purduerov/X19-USB-Hub-Board/X19-USB-Hub-Board.kicad_pcb

## KiCad design X19-USB-Hub-Board.kicad_pcb (2026-10-24)

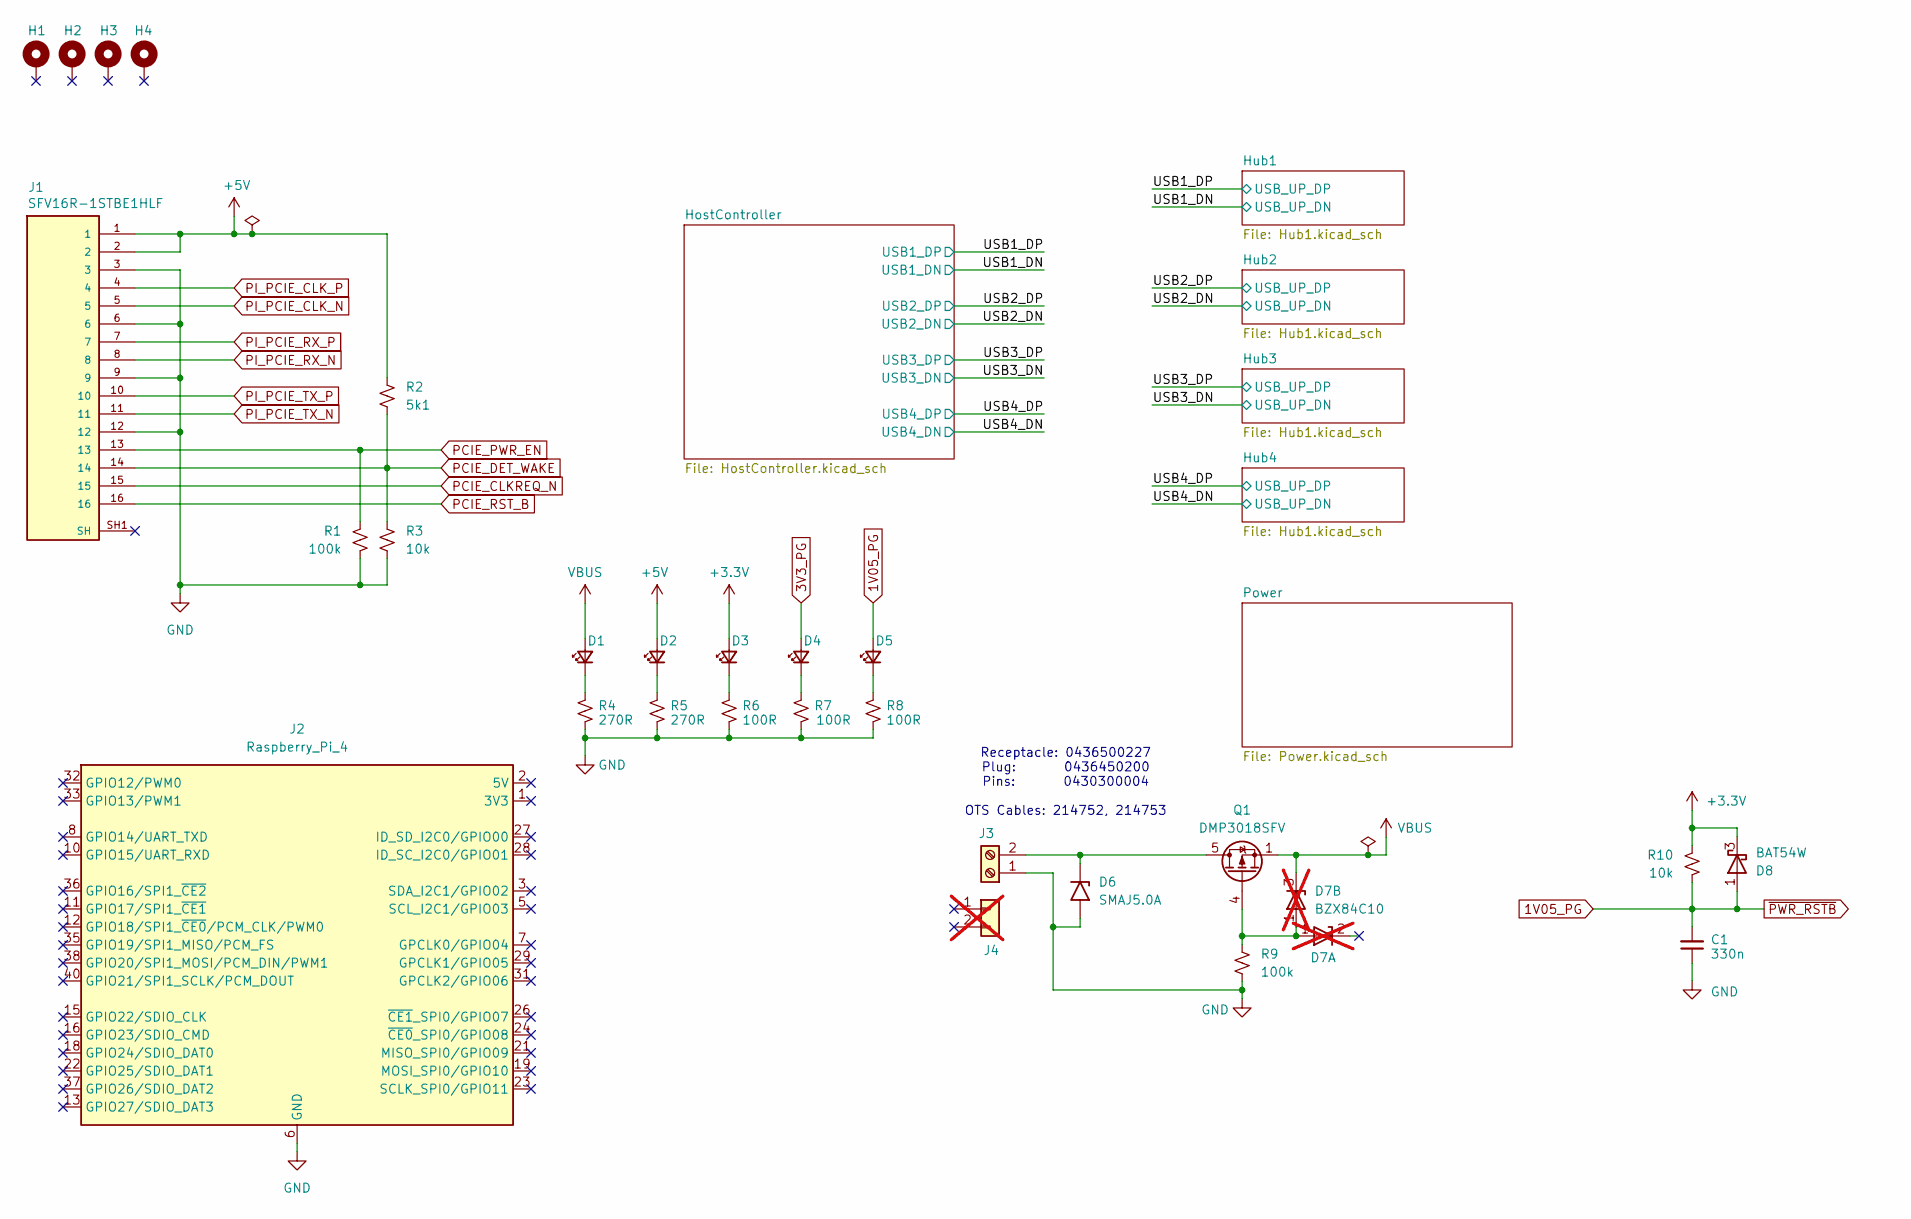
[picture p1: schematic X19-USB-Hub-Board.kicad_sch]

Parts:
C1: 330n; C_0402_1005Metric; Part Number CC0402KPX5R6BB334
D1, D2, D3, D4, D5: LED_Small; LED_0603_1608Metric; Part Number LTST-C190GKT
D6: SMAJ5.0A; D_SMA; Part Number SMAJ5.0A
D7: BZX84C10; SOT-23; Part Number BZX84C10; not fitted
D8: BAT54W; SOT-323_SC-70; Part Number BAT54W
H1, H2, H3, H4: MountingHole_Pad; MountingHole_2.7mm_M2.5_Pad
J1: SFV16R-1STBE1HLF; AMPHENOL_SFV16R-1STBE1HLF; PARTREV B; DigiKey 609-1786-1-ND
J2: Raspberry_Pi_4; PinSocket_2x20_P2.54mm_Vertical
J3: 0436500227; Part Number 1053131102
J4: 0436450200; Part Number 0436450200; not fitted
Q1: DMP3018SFV; Diodes_PowerDI3333-8; Part Number DMP3018SFV
R1, R9: 100k; R_0603_1608Metric; Part Number RC0603FR-07100KL
R2: 5k1; R_0603_1608Metric; Part Number RC0603FR-075K1L
R3, R10: 10k; R_0402_1005Metric; Part Number RC0402FR-0710KL
R4, R5: 270R; R_0603_1608Metric; Part Number RC0603FR-07270RL
R6, R7, R8: 100R; R_0603_1608Metric; Part Number RC0603FR-07100RL

Connections:
1V05_PG: C1.2, D5.2 (A), D8.1 (A), R10.2; also elsewhere on the board
3V3_PG: D4.2 (A); also elsewhere on the board
+3.3V: D3.2 (A), D8.3 (K), R10.1; also elsewhere on the board
+5V: D2.2 (A), J1.1, J1.2, R2.1; also elsewhere on the board
GND: C1.1, D6.2 (A2), J1.3, J1.6, J1.9, J1.12, J2.6 (GND), J2.9 (GND), J2.14 (GND), J2.20 (GND), J2.25 (GND), J2.30 (GND), J2.34 (GND), J2.39 (GND), J3.1, R1.2, R3.2, R4.1, R5.1, R6.1, R7.1, R8.1, R9.2; also elsewhere on the board
unnamed: D1.1 (K), R4.2
unnamed: D2.1 (K), R5.2
unnamed: D3.1 (K), R6.2
unnamed: D4.1 (K), R7.2
unnamed: D5.1 (K), R8.2
unnamed: D6.1 (A1), J3.2, Q1.5 (D)
unnamed: D7.1 (A), Q1.4 (G), R9.1
PCIE_CLKREQ_N: J1.15; also elsewhere on the board
PCIE_DET_WAKE: J1.14, R2.2, R3.1; also elsewhere on the board
PCIE_PWR_EN: J1.13, R1.1; also elsewhere on the board
PCIE_RST_B: J1.16; also elsewhere on the board
PI_PCIE_CLK_N: J1.5; also elsewhere on the board
PI_PCIE_CLK_P: J1.4; also elsewhere on the board
PI_PCIE_RX_N: J1.8; also elsewhere on the board
PI_PCIE_RX_P: J1.7; also elsewhere on the board
PI_PCIE_TX_N: J1.11; also elsewhere on the board
PI_PCIE_TX_P: J1.10; also elsewhere on the board
VBUS: D1.2 (A), D7.3 (K), Q1.1 (S), Q1.2 (S), Q1.3 (S); also elsewhere on the board

Notes on the sheet:
Receptacle: 0436500227 Plug: 0436450200 Pins: 0430300004 OTS Cables: 214752, 214753

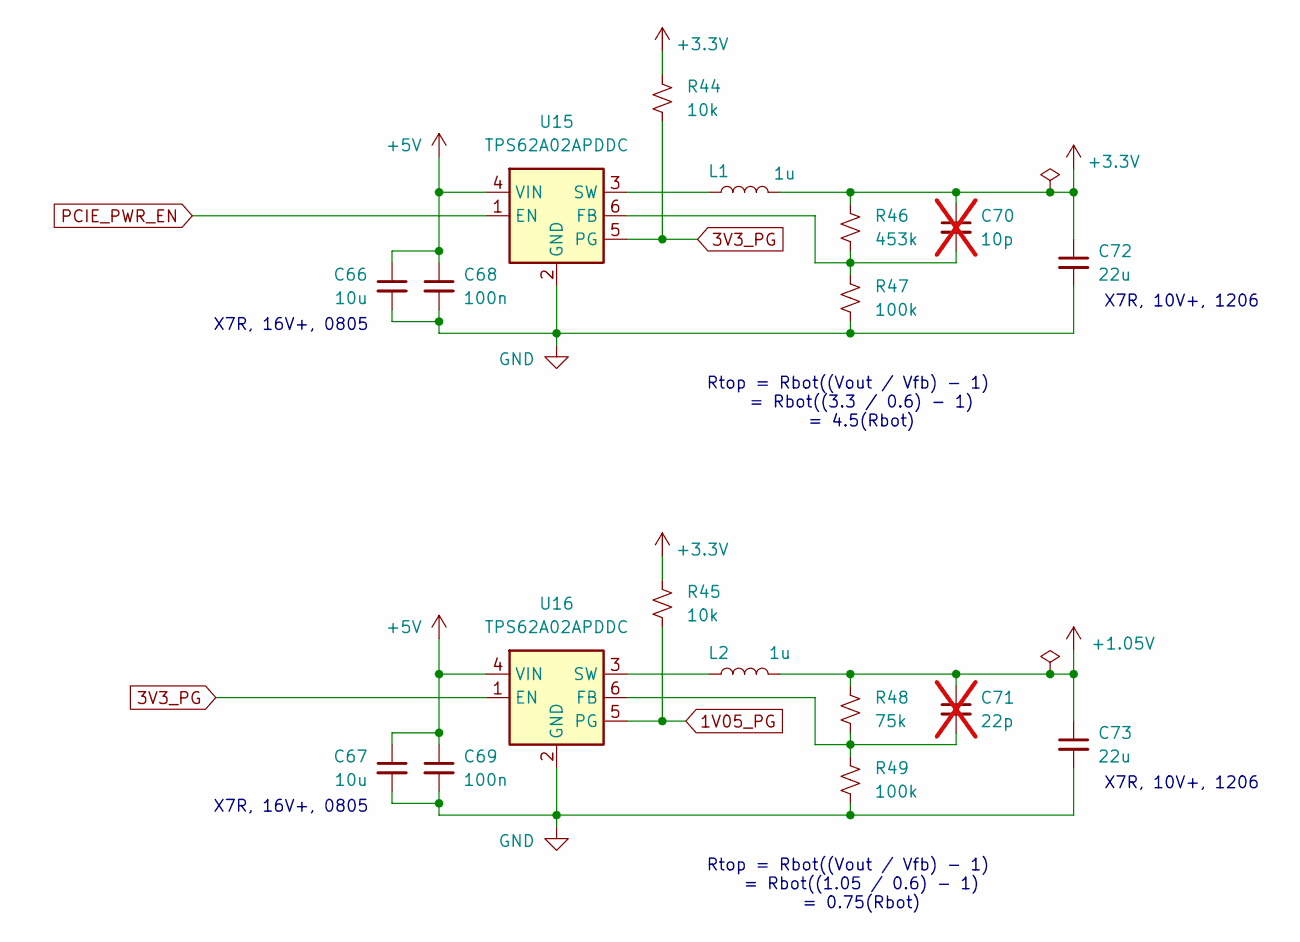
[picture p2: schematic Power.kicad_sch]

Parts:
C66, C67: 10u; C_0805_2012Metric; Part Number CC0805KRX5R8BB106
C68, C69: 100n; C_0402_1005Metric; Part Number CC0402KRX7R8BB104
C70: 10p; C_0402_1005Metric; Part Number CC0402JRNPO9BN100; not fitted
C71: 22p; C_0402_1005Metric; Part Number CC0402JRNPO9BN220; not fitted
C72, C73: 22u; C_1206_3216Metric; Part Number CC1206KKX5R8BB226
L1, L2: 1u; L_1008_2520Metric; Part Number DFE252012F-1R0M
R44, R45: 10k; R_0402_1005Metric; Part Number RC0402FR-0710KL
R46: 453k; R_0603_1608Metric; Part Number RC0603FR-07453KL
R47, R49: 100k; R_0603_1608Metric; Part Number RC0603FR-07100KL
R48: 75k; R_0603_1608Metric; Part Number RC0603FR-0775KL
U15, U16: TPS62A02APDDC; SOT-23-6; Part Number TPS62A02APDDC

Connections:
1V05_PG: R45.2, U16.5 (PG); also elsewhere on the board
3V3_PG: R44.2, U15.5 (PG), U16.1 (EN); also elsewhere on the board
+1.05V: C71.1, C73.1, L2.2, R48.1; also elsewhere on the board
+3.3V: C70.1, C72.1, L1.2, R44.1, R45.1, R46.1; also elsewhere on the board
+5V: C66.1, C67.1, C68.1, C69.1, U15.4 (VIN), U16.4 (VIN); also elsewhere on the board
GND: C66.2, C67.2, C68.2, C69.2, C72.2, C73.2, R47.2, R49.2, U15.2 (GND), U16.2 (GND); also elsewhere on the board
unnamed: C70.2, R46.2, R47.1, U15.6 (FB)
unnamed: L1.1, U15.3 (SW)
unnamed: C71.2, R48.2, R49.1, U16.6 (FB)
unnamed: L2.1, U16.3 (SW)
PCIE_PWR_EN: U15.1 (EN); also elsewhere on the board

Notes on the sheet:
X7R, 10V+, 1206
Rtop = Rbot((Vout / Vfb) - 1) = Rbot((1.05 / 0.6) - 1) = 0.75(Rbot)
Rtop = Rbot((Vout / Vfb) - 1) = Rbot((3.3 / 0.6) - 1) = 4.5(Rbot)
X7R, 16V+, 0805

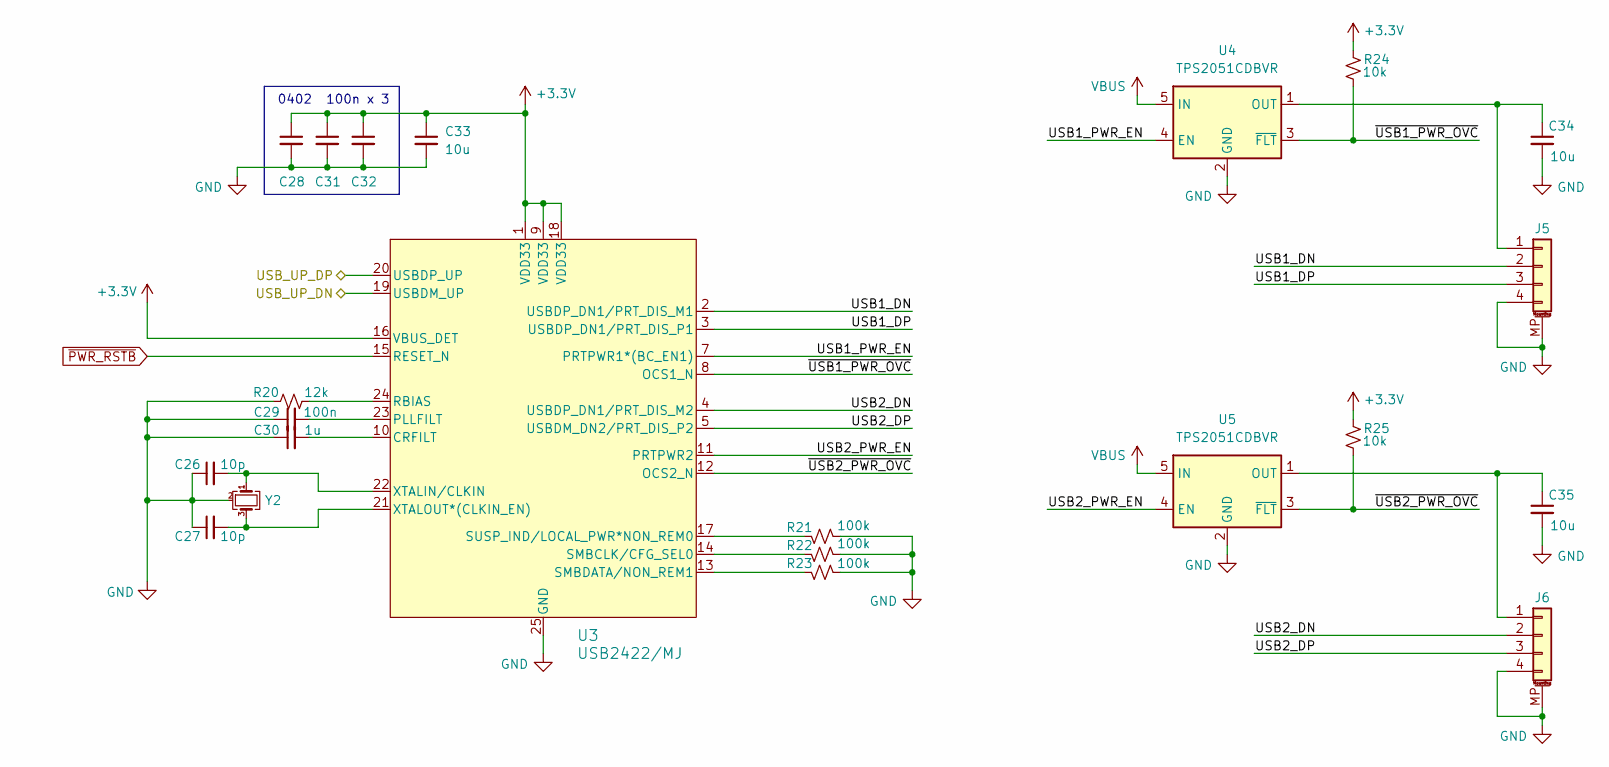
[picture p3: schematic Hub1.kicad_sch]

Parts:
C26, C27: 10p; C_0402_1005Metric; Part Number CC0402JRNPO9BN100
C28, C29, C31, C32: 100n; C_0402_1005Metric; Part Number CC0402KRX7R8BB104
C30: 1u; C_0603_1608Metric; Part Number CC0603KRX5R6BB105
C33, C34, C35: 10u; C_0805_2012Metric; Part Number CC0805KRX5R8BB106
J5, J6: BM04B-SRSS-TB; JST_SH_BM04B-SRSS-TB_1x04-1MP_P1.00mm_Vertical; Part Number BM04B-SRSS-TB
R20: 12k; R_0603_1608Metric; Part Number RC0603FR-0712KL
R21, R22, R23: 100k; R_0603_1608Metric; Part Number RC0603FR-07100KL
R24, R25: 10k; R_0402_1005Metric; Part Number RC0402FR-0710KL
U3: USB2422/MJ; QFN-24-1EP_4x4mm_P0.5mm_EP2.5x2.5mm_ThermalVias; Part Number USB2422/MJ; DigiKey USB2422/MJ-ND
U4, U5: TPS2051CDBVR; SOT-23-5; Part Number TPS2051CDBVR
Y2: ECS-240-8-37B-CKY-TR; Crystal_SMD_2016-4Pin_2.0x1.6mm; Part Number ECS-240-8-37B-CKY-TR

Connections:
1V05_PG: U3.15 (RESET_N); also elsewhere on the board
+3.3V: C28.1, C31.1, C32.1, C33.1, R24.1, R25.1, U3.1 (VDD33), U3.9 (VDD33), U3.16 (VBUS_DET), U3.18 (VDD33); also elsewhere on the board
/Hub1/USB1_DN: J5.2, U3.2 (USBDP_DN1/PRT_DIS_M1)
/Hub1/USB1_DP: J5.3, U3.3 (USBDP_DN1/PRT_DIS_P1)
/Hub1/USB1_PWR_EN: U3.7 (PRTPWR1*(BC_EN1)), U4.4 (EN)
/Hub1/USB2_DN: J6.2, U3.4 (USBDP_DN1/PRT_DIS_M2)
/Hub1/USB2_DP: J6.3, U3.5 (USBDM_DN2/PRT_DIS_P2)
/Hub1/USB2_PWR_EN: U3.11 (PRTPWR2), U5.4 (EN)
/Hub1/~USB1_PWR_OVC: R24.2, U3.8 (OCS1_N), U4.3 (~FLT)
/Hub1/~USB2_PWR_OVC: R25.2, U3.12 (OCS2_N), U5.3 (~FLT)
/USB1_DN: U3.19 (USBDM_UP); also elsewhere on the board
/USB1_DP: U3.20 (USBDP_UP); also elsewhere on the board
GND: C26.1, C27.1, C28.2, C29.1, C30.1, C31.2, C32.2, C33.2, C34.2, C35.2, J5.4, J5.MP (MountPin), J6.4, J6.MP (MountPin), R20.1, R21.2, R22.2, R23.2, U3.25 (GND), U4.2 (GND), U5.2 (GND), Y2.2 (G), Y2.4 (G); also elsewhere on the board
unnamed: C34.1, J5.1, U4.1 (OUT)
unnamed: C35.1, J6.1, U5.1 (OUT)
unnamed: C30.2, U3.10 (CRFILT)
unnamed: C29.2, U3.23 (PLLFILT)
unnamed: R20.2, U3.24 (RBIAS)
unnamed: R22.1, U3.14 (SMBCLK/CFG_SEL0)
unnamed: R23.1, U3.13 (SMBDATA/NON_REM1)
unnamed: R21.1, U3.17 (SUSP_IND/LOCAL_PWR*NON_REM0)
unnamed: C26.2, U3.22 (XTALIN/CLKIN), Y2.1
unnamed: C27.2, U3.21 (XTALOUT*(CLKIN_EN)), Y2.3
VBUS: U4.5 (IN), U5.5 (IN); also elsewhere on the board

Parts of its further copies:
C36, C37, C46, C47, C56, C57: 10p; C_0402_1005Metric; Part Number CC0402JRNPO9BN100
C38, C39, C41, C42, C48, C49, C51, C52, C58, C59, C61, C62: 100n; C_0402_1005Metric; Part Number CC0402KRX7R8BB104
C40, C50, C60: 1u; C_0603_1608Metric; Part Number CC0603KRX5R6BB105
C43, C44, C45, C53, C54, C55, C63, C64, C65: 10u; C_0805_2012Metric; Part Number CC0805KRX5R8BB106
J7, J8, J9, J10, J11, J12: BM04B-SRSS-TB; JST_SH_BM04B-SRSS-TB_1x04-1MP_P1.00mm_Vertical; Part Number BM04B-SRSS-TB
R26, R32, R38: 12k; R_0603_1608Metric; Part Number RC0603FR-0712KL
R27, R28, R29, R33, R34, R35, R39, R40, R41: 100k; R_0603_1608Metric; Part Number RC0603FR-07100KL
R30, R31, R36, R37, R42, R43: 10k; R_0402_1005Metric; Part Number RC0402FR-0710KL
U6, U9, U12: USB2422/MJ; QFN-24-1EP_4x4mm_P0.5mm_EP2.5x2.5mm_ThermalVias; Part Number USB2422/MJ; DigiKey USB2422/MJ-ND
U7, U8, U10, U11, U13, U14: TPS2051CDBVR; SOT-23-5; Part Number TPS2051CDBVR
Y3, Y4, Y5: ECS-240-8-37B-CKY-TR; Crystal_SMD_2016-4Pin_2.0x1.6mm; Part Number ECS-240-8-37B-CKY-TR

Connections of its further copies:
1V05_PG: U6.15 (RESET_N), U9.15 (RESET_N), U12.15 (RESET_N); also elsewhere on the board
+3.3V: C38.1, C41.1, C42.1, C43.1, C48.1, C51.1, C52.1, C53.1, C58.1, C61.1, C62.1, C63.1, R30.1, R31.1, R36.1, R37.1, R42.1, R43.1, U6.1 (VDD33), U6.9 (VDD33), U6.16 (VBUS_DET), U6.18 (VDD33), U9.1 (VDD33), U9.9 (VDD33), U9.16 (VBUS_DET), U9.18 (VDD33), U12.1 (VDD33), U12.9 (VDD33), U12.16 (VBUS_DET), U12.18 (VDD33); also elsewhere on the board
/Hub2/USB1_DN: J7.2, U6.2 (USBDP_DN1/PRT_DIS_M1)
/Hub2/USB1_DP: J7.3, U6.3 (USBDP_DN1/PRT_DIS_P1)
/Hub2/USB1_PWR_EN: U6.7 (PRTPWR1*(BC_EN1)), U7.4 (EN)
/Hub2/USB2_DN: J8.2, U6.4 (USBDP_DN1/PRT_DIS_M2)
/Hub2/USB2_DP: J8.3, U6.5 (USBDM_DN2/PRT_DIS_P2)
/Hub2/USB2_PWR_EN: U6.11 (PRTPWR2), U8.4 (EN)
/Hub2/~USB1_PWR_OVC: R30.2, U6.8 (OCS1_N), U7.3 (~FLT)
/Hub2/~USB2_PWR_OVC: R31.2, U6.12 (OCS2_N), U8.3 (~FLT)
/Hub3/USB1_DN: J9.2, U9.2 (USBDP_DN1/PRT_DIS_M1)
/Hub3/USB1_DP: J9.3, U9.3 (USBDP_DN1/PRT_DIS_P1)
/Hub3/USB1_PWR_EN: U9.7 (PRTPWR1*(BC_EN1)), U10.4 (EN)
/Hub3/USB2_DN: J10.2, U9.4 (USBDP_DN1/PRT_DIS_M2)
/Hub3/USB2_DP: J10.3, U9.5 (USBDM_DN2/PRT_DIS_P2)
/Hub3/USB2_PWR_EN: U9.11 (PRTPWR2), U11.4 (EN)
/Hub3/~USB1_PWR_OVC: R36.2, U9.8 (OCS1_N), U10.3 (~FLT)
/Hub3/~USB2_PWR_OVC: R37.2, U9.12 (OCS2_N), U11.3 (~FLT)
/Hub4/USB1_DN: J11.2, U12.2 (USBDP_DN1/PRT_DIS_M1)
/Hub4/USB1_DP: J11.3, U12.3 (USBDP_DN1/PRT_DIS_P1)
/Hub4/USB1_PWR_EN: U12.7 (PRTPWR1*(BC_EN1)), U13.4 (EN)
/Hub4/USB2_DN: J12.2, U12.4 (USBDP_DN1/PRT_DIS_M2)
/Hub4/USB2_DP: J12.3, U12.5 (USBDM_DN2/PRT_DIS_P2)
/Hub4/USB2_PWR_EN: U12.11 (PRTPWR2), U14.4 (EN)
/Hub4/~USB1_PWR_OVC: R42.2, U12.8 (OCS1_N), U13.3 (~FLT)
/Hub4/~USB2_PWR_OVC: R43.2, U12.12 (OCS2_N), U14.3 (~FLT)
/USB2_DN: U6.19 (USBDM_UP); also elsewhere on the board
/USB2_DP: U6.20 (USBDP_UP); also elsewhere on the board
/USB3_DN: U9.19 (USBDM_UP); also elsewhere on the board
/USB3_DP: U9.20 (USBDP_UP); also elsewhere on the board
/USB4_DN: U12.19 (USBDM_UP); also elsewhere on the board
/USB4_DP: U12.20 (USBDP_UP); also elsewhere on the board
GND: C36.1, C37.1, C38.2, C39.1, C40.1, C41.2, C42.2, C43.2, C44.2, C45.2, C46.1, C47.1, C48.2, C49.1, C50.1, C51.2, C52.2, C53.2, C54.2, C55.2, C56.1, C57.1, C58.2, C59.1, C60.1, C61.2, C62.2, C63.2, C64.2, C65.2, J7.4, J7.MP (MountPin), J8.4, J8.MP (MountPin), J9.4, J9.MP (MountPin), J10.4, J10.MP (MountPin), J11.4, J11.MP (MountPin), J12.4, J12.MP (MountPin), R26.1, R27.2, R28.2, R29.2, R32.1, R33.2, R34.2, R35.2, R38.1, R39.2, R40.2, R41.2, U6.25 (GND), U7.2 (GND), U8.2 (GND), U9.25 (GND), U10.2 (GND), U11.2 (GND), U12.25 (GND), U13.2 (GND), U14.2 (GND), Y3.2 (G), Y3.4 (G), Y4.2 (G), Y4.4 (G), Y5.2 (G), Y5.4 (G); also elsewhere on the board
unnamed: C44.1, J7.1, U7.1 (OUT)
unnamed: C45.1, J8.1, U8.1 (OUT)
unnamed: C54.1, J9.1, U10.1 (OUT)
unnamed: C55.1, J10.1, U11.1 (OUT)
unnamed: C64.1, J11.1, U13.1 (OUT)
unnamed: C65.1, J12.1, U14.1 (OUT)
unnamed: C40.2, U6.10 (CRFILT)
unnamed: C39.2, U6.23 (PLLFILT)
unnamed: R26.2, U6.24 (RBIAS)
unnamed: R28.1, U6.14 (SMBCLK/CFG_SEL0)
unnamed: R29.1, U6.13 (SMBDATA/NON_REM1)
unnamed: R27.1, U6.17 (SUSP_IND/LOCAL_PWR*NON_REM0)
unnamed: C36.2, U6.22 (XTALIN/CLKIN), Y3.1
unnamed: C37.2, U6.21 (XTALOUT*(CLKIN_EN)), Y3.3
unnamed: C50.2, U9.10 (CRFILT)
unnamed: C49.2, U9.23 (PLLFILT)
unnamed: R32.2, U9.24 (RBIAS)
unnamed: R34.1, U9.14 (SMBCLK/CFG_SEL0)
unnamed: R35.1, U9.13 (SMBDATA/NON_REM1)
unnamed: R33.1, U9.17 (SUSP_IND/LOCAL_PWR*NON_REM0)
unnamed: C46.2, U9.22 (XTALIN/CLKIN), Y4.1
unnamed: C47.2, U9.21 (XTALOUT*(CLKIN_EN)), Y4.3
unnamed: C60.2, U12.10 (CRFILT)
unnamed: C59.2, U12.23 (PLLFILT)
unnamed: R38.2, U12.24 (RBIAS)
unnamed: R40.1, U12.14 (SMBCLK/CFG_SEL0)
unnamed: R41.1, U12.13 (SMBDATA/NON_REM1)
unnamed: R39.1, U12.17 (SUSP_IND/LOCAL_PWR*NON_REM0)
unnamed: C56.2, U12.22 (XTALIN/CLKIN), Y5.1
unnamed: C57.2, U12.21 (XTALOUT*(CLKIN_EN)), Y5.3
VBUS: U7.5 (IN), U8.5 (IN), U10.5 (IN), U11.5 (IN), U13.5 (IN), U14.5 (IN); also elsewhere on the board

Notes on the sheet:
0402
100n x 3

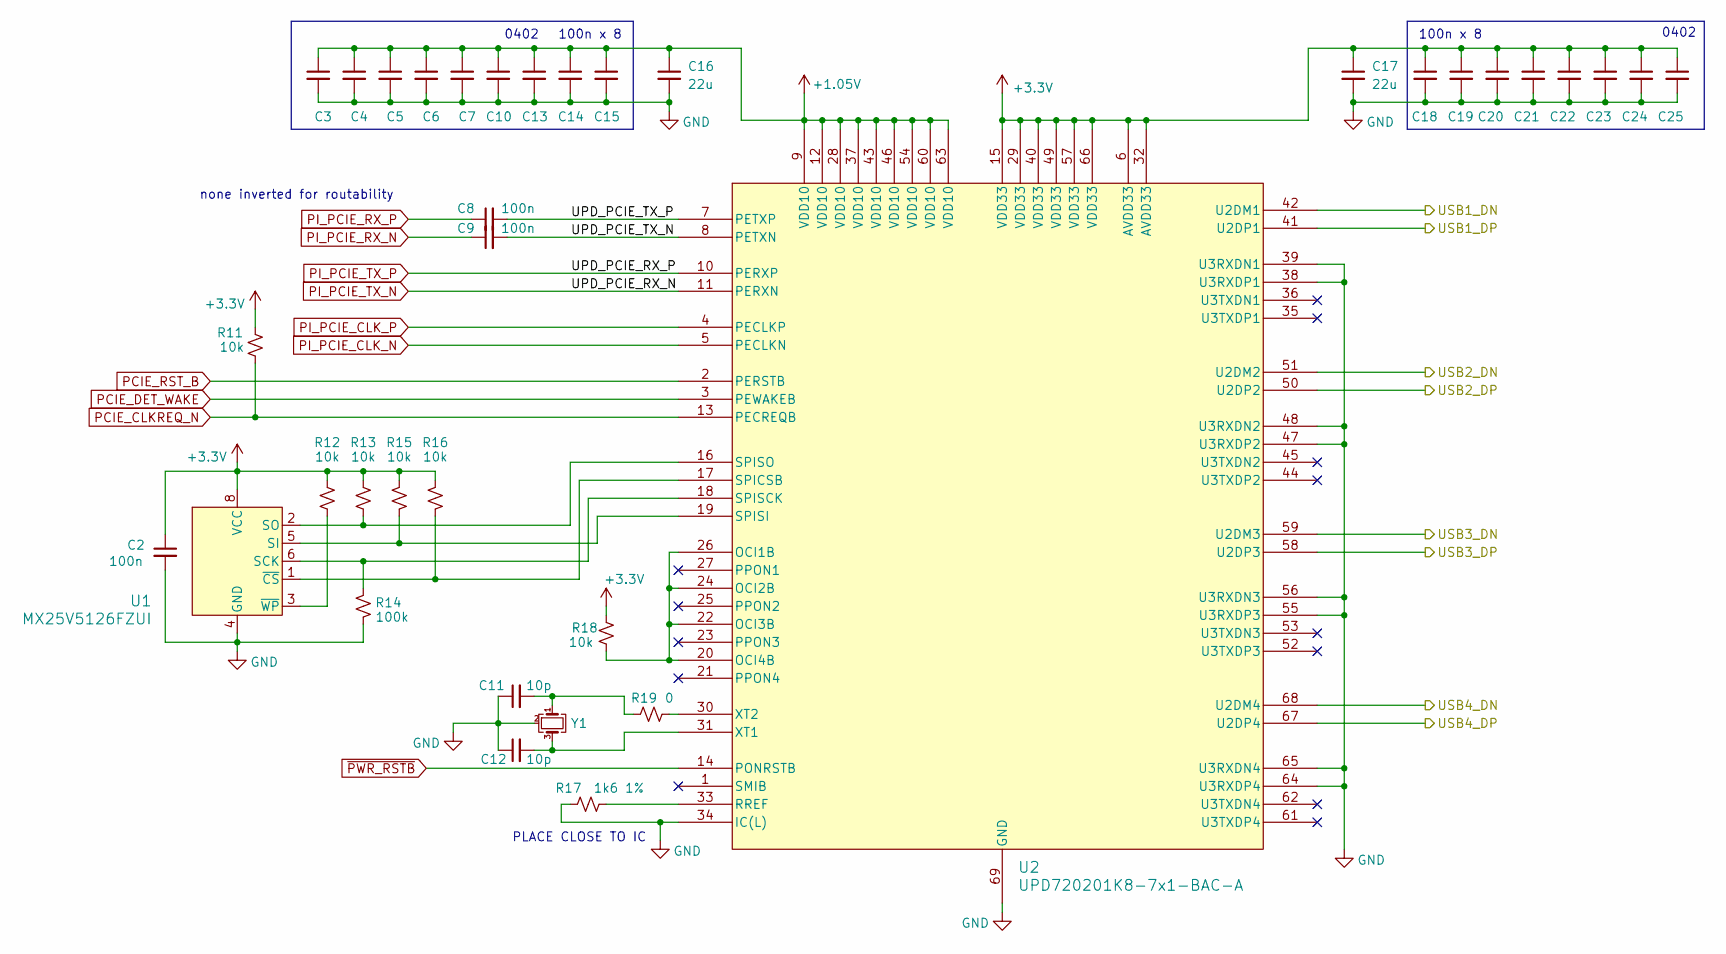
[picture p4: schematic HostController.kicad_sch]

Parts:
C2, C3, C4, C5, C6, C7, C8, C9, C10, C13, C14, C15, C18, C19, C20, C21, C22, C23, C24, C25: 100n; C_0402_1005Metric; Part Number CC0402KRX7R8BB104
C11, C12: 10p; C_0402_1005Metric; Part Number CC0402JRNPO9BN100
C16, C17: 22u; C_1206_3216Metric; Part Number CC1206KKX5R8BB226
R11, R12, R13, R15, R16, R18: 10k; R_0402_1005Metric; Part Number RC0402FR-0710KL
R14: 100k; R_0603_1608Metric; Part Number RC0603FR-07100KL
R17: 1k6 1%; R_0603_1608Metric; Part Number RC0603FR-071K6L
R19: 0; R_0402_1005Metric; Part Number RC0402FR-070RL
U1: MX25V5126FZUI; Winbond_USON-8-1EP_3x2mm_P0.5mm_EP0.2x1.6mm; Part Number MX25V5126FZUI; DigiKey 1092-1065-1-ND
U2: UPD720201K8-7x1-BAC-A; QFN-68-1EP_8x8mm_P0.4mm_EP6.2x6.2mm; Part Number UPD720201K8-701-BAC-A; DigiKey UPD720201K8-711-BAC-ACT-ND
Y1: ECS-240-8-37B-CKY-TR; Crystal_SMD_2016-4Pin_2.0x1.6mm; Part Number ECS-240-8-37B-CKY-TR

Connections:
1V05_PG: U2.14 (PONRSTB); also elsewhere on the board
+1.05V: C3.1, C4.1, C5.1, C6.1, C7.1, C10.1, C13.1, C14.1, C15.1, C16.1, U2.9 (VDD10), U2.12 (VDD10), U2.28 (VDD10), U2.37 (VDD10), U2.43 (VDD10), U2.46 (VDD10), U2.54 (VDD10), U2.60 (VDD10), U2.63 (VDD10); also elsewhere on the board
+3.3V: C2.1, C17.1, C18.1, C19.1, C20.1, C21.1, C22.1, C23.1, C24.1, C25.1, R11.1, R12.1, R13.1, R15.1, R16.1, R18.1, U1.8 (VCC), U2.6 (AVDD33), U2.15 (VDD33), U2.29 (VDD33), U2.32 (AVDD33), U2.40 (VDD33), U2.49 (VDD33), U2.57 (VDD33), U2.66 (VDD33); also elsewhere on the board
/HostController/UPD_PCIE_TX_N: C9.2, U2.8 (PETXN)
/HostController/UPD_PCIE_TX_P: C8.2, U2.7 (PETXP)
/USB1_DN: U2.42 (U2DM1); also elsewhere on the board
/USB1_DP: U2.41 (U2DP1); also elsewhere on the board
/USB2_DN: U2.51 (U2DM2); also elsewhere on the board
/USB2_DP: U2.50 (U2DP2); also elsewhere on the board
/USB3_DN: U2.59 (U2DM3); also elsewhere on the board
/USB3_DP: U2.58 (U2DP3); also elsewhere on the board
/USB4_DN: U2.68 (U2DM4); also elsewhere on the board
/USB4_DP: U2.67 (U2DP4); also elsewhere on the board
GND: C2.2, C3.2, C4.2, C5.2, C6.2, C7.2, C10.2, C11.1, C12.1, C13.2, C14.2, C15.2, C16.2, C17.2, C18.2, C19.2, C20.2, C21.2, C22.2, C23.2, C24.2, C25.2, R14.2, R17.1, U1.4 (GND), U1.9 (EP), U2.34 (IC(L)), U2.38 (U3RXDP1), U2.39 (U3RXDN1), U2.47 (U3RXDP2), U2.48 (U3RXDN2), U2.55 (U3RXDP3), U2.56 (U3RXDN3), U2.64 (U3RXDP4), U2.65 (U3RXDN4), U2.69 (GND), Y1.2 (G), Y1.4 (G); also elsewhere on the board
unnamed: C11.2, R19.1, Y1.1
unnamed: R14.1, U1.6 (SCK), U2.18 (SPISCK)
unnamed: R15.2, U1.5 (SI), U2.19 (SPISI)
unnamed: R13.2, U1.2 (SO), U2.16 (SPISO)
unnamed: R16.2, U1.1 (~CS), U2.17 (SPICSB)
unnamed: R12.2, U1.3 (~WP)
unnamed: R18.2, U2.20 (OCI4B), U2.22 (OCI3B), U2.24 (OCI2B), U2.26 (OCI1B)
unnamed: R17.2, U2.33 (RREF)
unnamed: C12.2, U2.31 (XT1), Y1.3
unnamed: R19.2, U2.30 (XT2)
PCIE_CLKREQ_N: R11.2, U2.13 (PECREQB); also elsewhere on the board
PCIE_DET_WAKE: U2.3 (PEWAKEB); also elsewhere on the board
PCIE_RST_B: U2.2 (PERSTB); also elsewhere on the board
PI_PCIE_CLK_N: U2.5 (PECLKN); also elsewhere on the board
PI_PCIE_CLK_P: U2.4 (PECLKP); also elsewhere on the board
PI_PCIE_RX_N: C9.1; also elsewhere on the board
PI_PCIE_RX_P: C8.1; also elsewhere on the board
PI_PCIE_TX_N: U2.11 (PERXN); also elsewhere on the board
PI_PCIE_TX_P: U2.10 (PERXP); also elsewhere on the board

Notes on the sheet:
100n x 8
0402
none inverted for routability
PLACE CLOSE TO IC

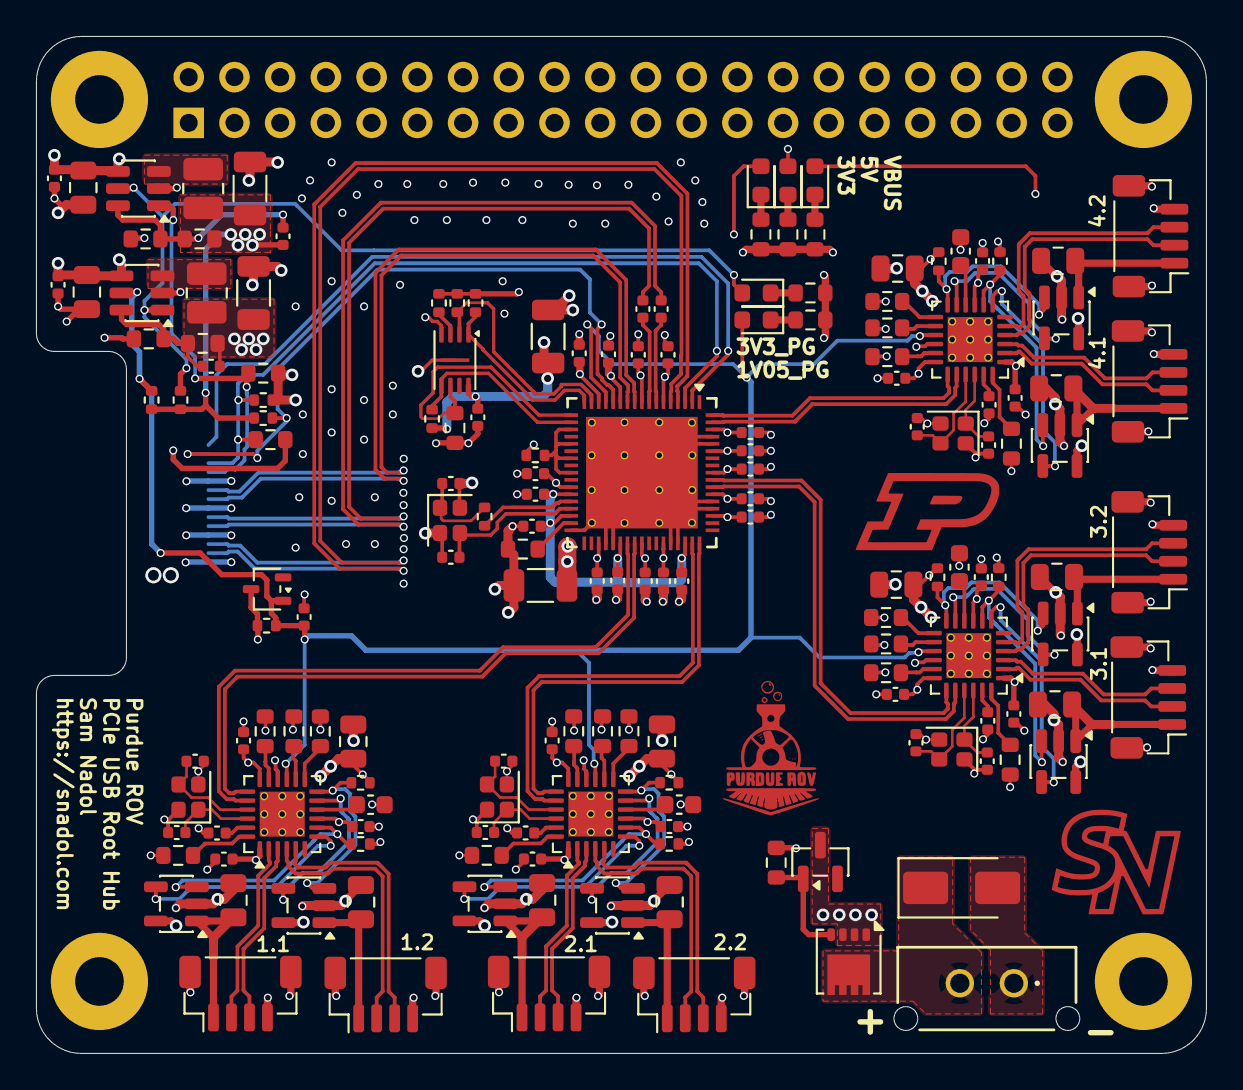
[picture p5: board X19-USB-Hub-Board.kicad_pcb from above]

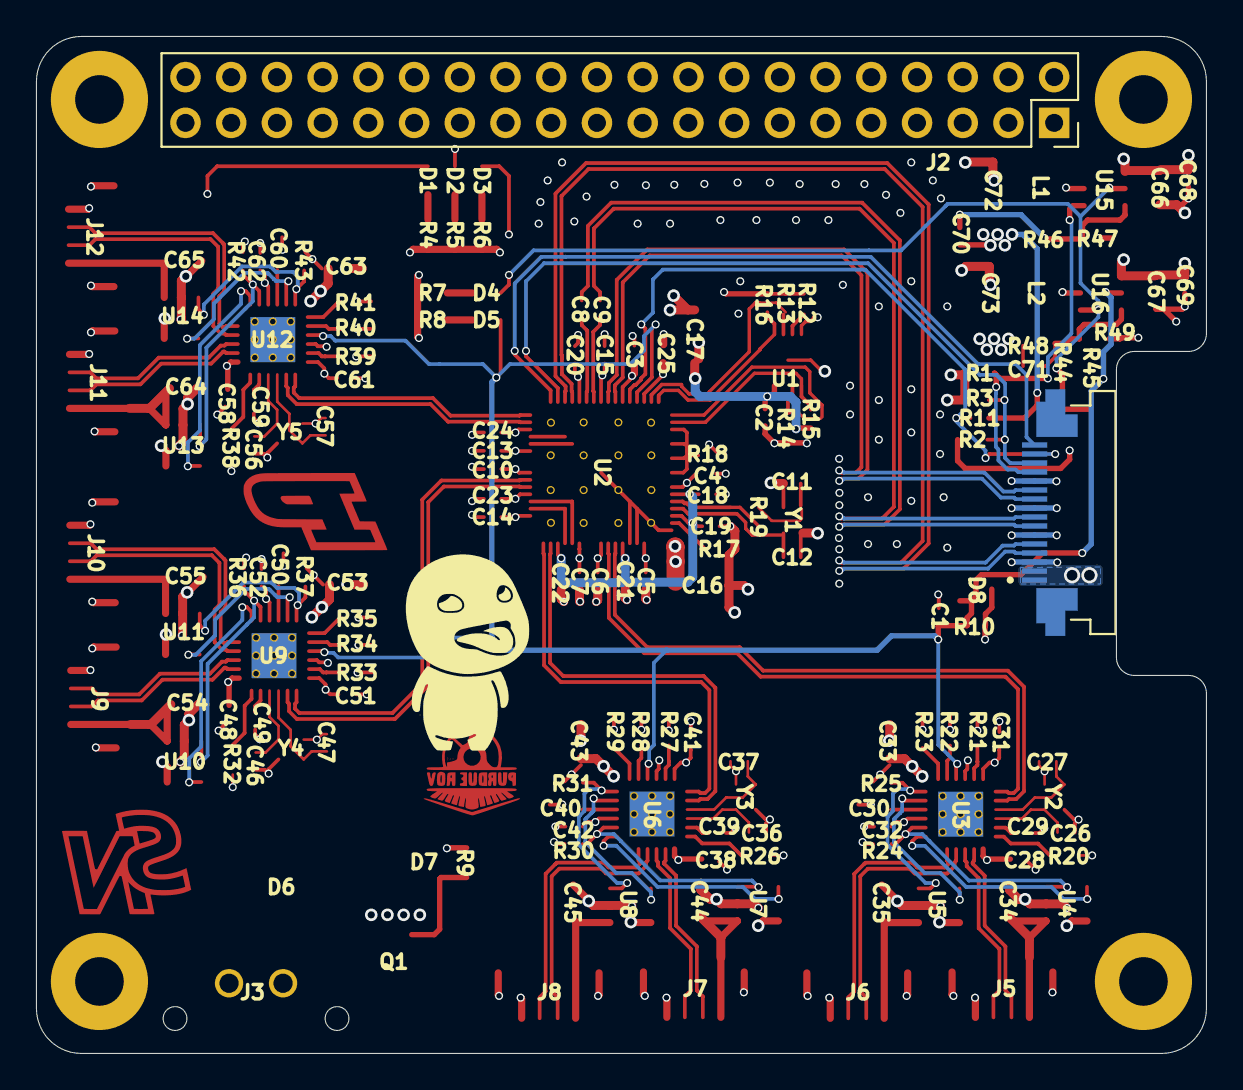
[picture p6: board X19-USB-Hub-Board.kicad_pcb from below]

Board: 4 copper layers, 65.0 x 56.5 mm, 169 parts (2 on the bottom side), 120 nets.
