purduerov/X19-USB-Hub-Board/(commit log)

2026-09-19 chore: initialize project name to X19-USB-Hub-Board and cleanup template config
    [X19-USB-Hub-Board.kicad_pcb, X19-USB-Hub-Board.kicad_sch]
2026-09-19 push existing board
    [HostController.kicad_sch, Hub1.kicad_sch, Power.kicad_sch, ROV_PCIE_USB_HUB_FINAL.kicad_pcb, ROV_PCIE_USB_HUB_FINAL.kicad_sch, USB_HUB.step, X19-USB-Hub-Board.kicad_pcb, X19-USB-Hub-Board.kicad_sch]
2026-09-19 refactor: standardize project structure and link central purdue-rov-kicad-lib
    [HostController.kicad_sch, Hub1.kicad_sch, Power.kicad_sch, X19-USB-Hub-Board.kicad_pcb, X19-USB-Hub-Board.kicad_sch]
2026-09-19 ci: set strict_drc to false to generate PDFs and artifacts for WIP boards
2026-09-22 readme + board changes
    [HostController.kicad_sch, Hub1.kicad_sch, Power.kicad_sch, USB_HUB.step, X19-USB-Hub-Board.kicad_pcb, X19-USB-Hub-Board.kicad_sch]
2026-09-24 chore(submodule): update purdue-rov-kicad-lib to latest master
2026-09-24 chore(submodule): auto-update purdue-rov-kicad-lib to latest master
2026-09-26 feat: adopt ROV PCB platform contract
2026-09-26 ci: grant the reusable update workflow least-privilege permissions
    A reusable workflow can only narrow the caller's token, never widen it, so this
    wrapper has to declare what the called workflow asks for. Without its own
    permissions block the call is clamped to the repository default, which is
    read-only on several boards, and every scheduled library update fails to push
    the update branch or open its pull request while still looking green. The five
    documented inputs are unchanged.
2026-09-26 chore: ignore KiCad project backup archives
2026-10-12 chore(library): update purdue-rov-kicad-lib submodule
